dinhanh7/Logic_Analyzer_20261/dinhanh/PCB/LogicAnalyzer_Pico2/review/PCB_3D_isometric.png

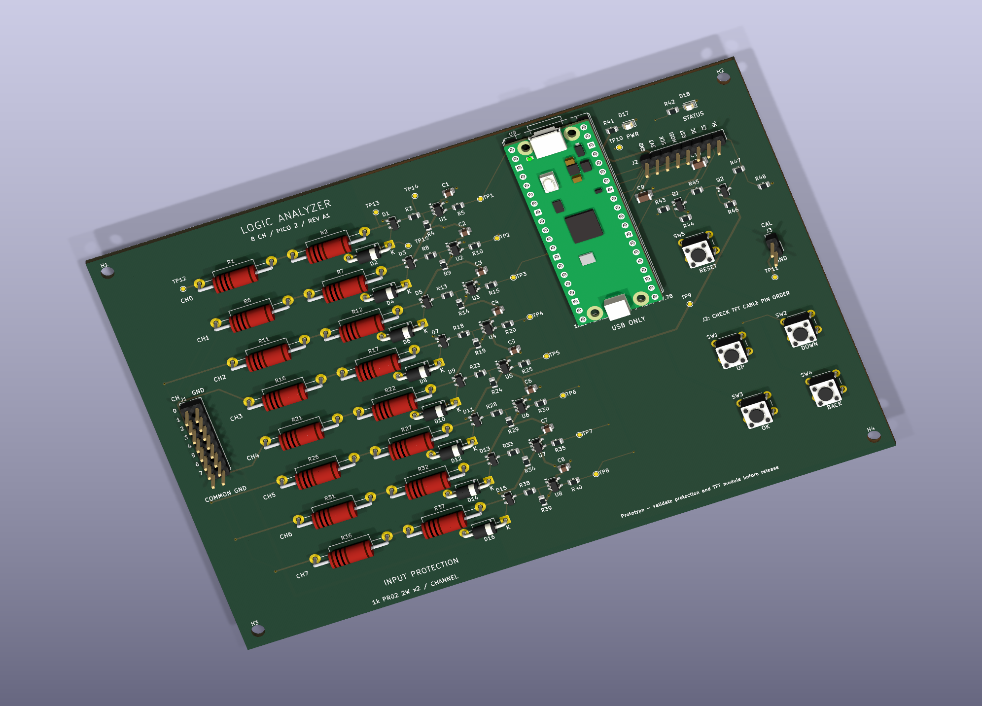
dinhanh/PCB/LogicAnalyzer_Pico2/review/PCB_3D_isometric.png
