dinhanh7/Logic_Analyzer_20261/dinhanh/PCB/LogicAnalyzer_Pico2/review/PCB_bottom.png

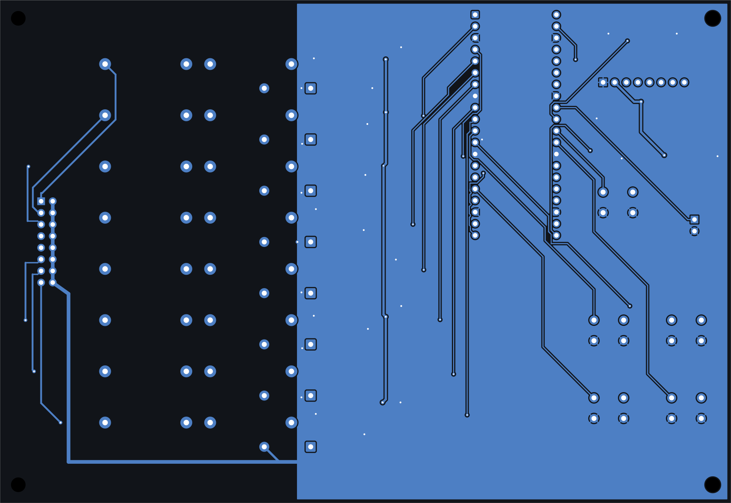
dinhanh/PCB/LogicAnalyzer_Pico2/review/PCB_bottom.png
