dinhanh7/Logic_Analyzer_20261/dinhanh/PCB/LogicAnalyzer_Pico2/models/RaspberryPi_Pico_H.step

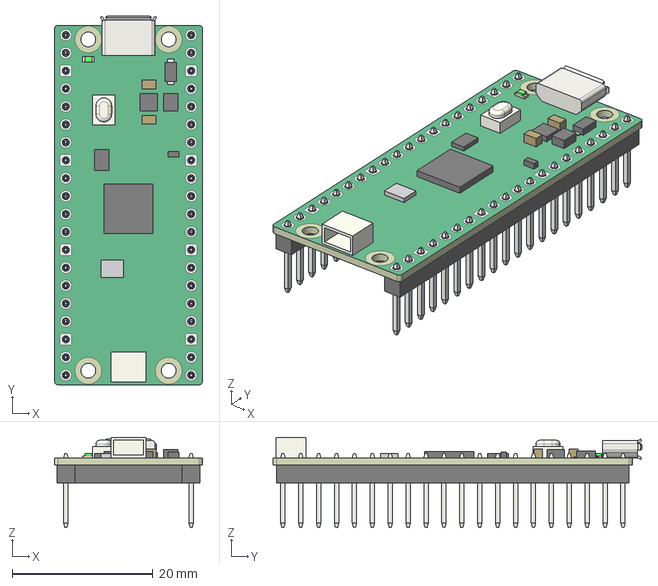
[picture p84: CAD file, 2026-11-11]
dinhanh/PCB/LogicAnalyzer_Pico2/models/RaspberryPi_Pico_H.step
21.0 x 52.3 x 12.8 mm
