dinhanh7/Logic_Analyzer_20261/dinhanh/PCB/LogicAnalyzer_Pico2/models/RaspberryPi_Pico_W_AddedHeaders_H2.54mm.step

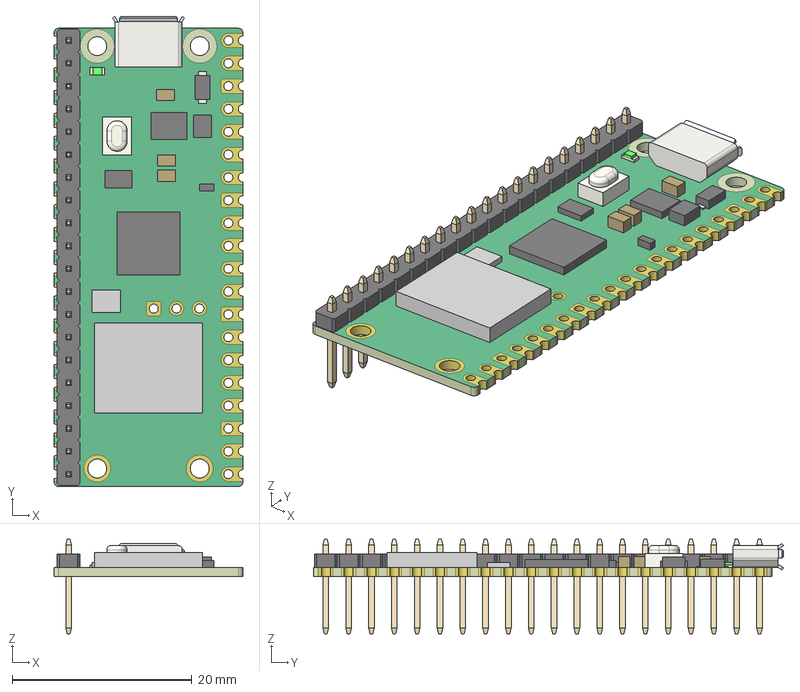
[picture p85: CAD file, 2026-11-11]
dinhanh/PCB/LogicAnalyzer_Pico2/models/RaspberryPi_Pico_W_AddedHeaders_H2.54mm.step
21.0 x 52.3 x 10.5 mm
