dinhanh7/Logic_Analyzer_20261/dinhanh/PCB/LogicAnalyzer_Pico2/models/SW_PUSH_6mm.step

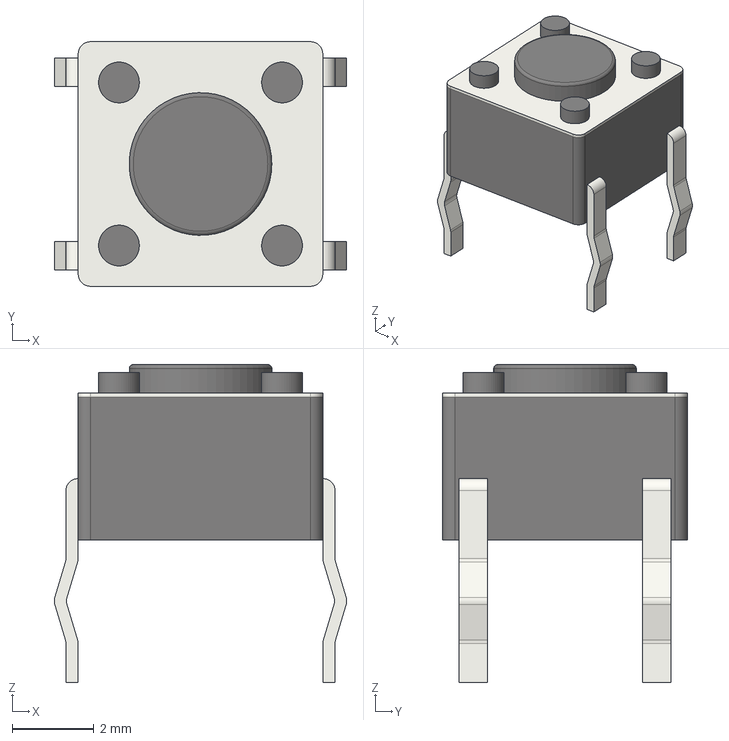
[picture p87: CAD file, 2026-11-11]
dinhanh/PCB/LogicAnalyzer_Pico2/models/SW_PUSH_6mm.step
7.17 x 6.00 x 7.80 mm
