dinhanh7/Logic_Analyzer_20261/dinhanh/PCB/LogicAnalyzer_Pico2/models/RaspberryPi_Pico_PinSockets_H8.50mm.step

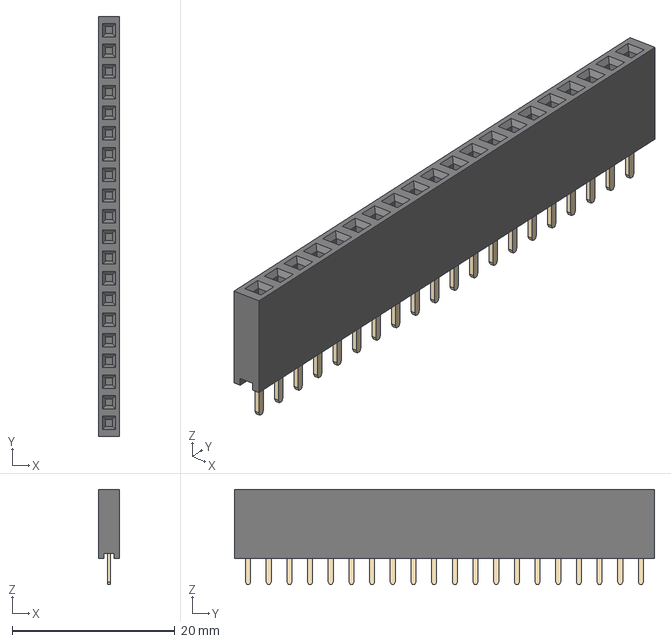
[picture p88: CAD file, 2026-11-11]
dinhanh/PCB/LogicAnalyzer_Pico2/models/RaspberryPi_Pico_PinSockets_H8.50mm.step
2.54 x 51.6 x 11.7 mm
