dinhanh7/Logic_Analyzer_20261/dinhanh/PCB/LogicAnalyzer_Pico2/models/LED_0805_2012Metric.step

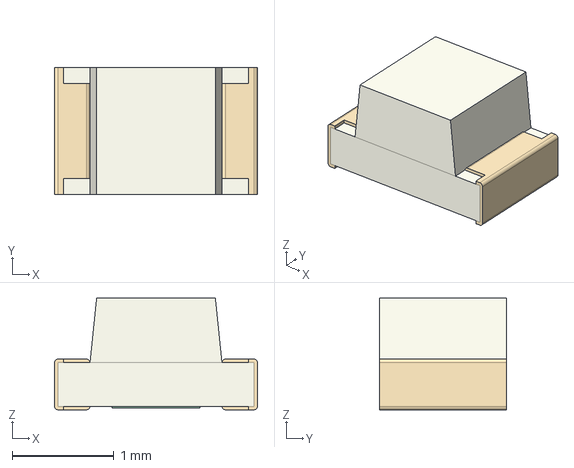
[picture p89: CAD file, 2026-11-11]
dinhanh/PCB/LogicAnalyzer_Pico2/models/LED_0805_2012Metric.step
2.00 x 1.25 x 1.10 mm
