dinhanh7/Logic_Analyzer_20261/dinhanh/PCB/LogicAnalyzer_Pico2/models/C_0805_2012Metric.step

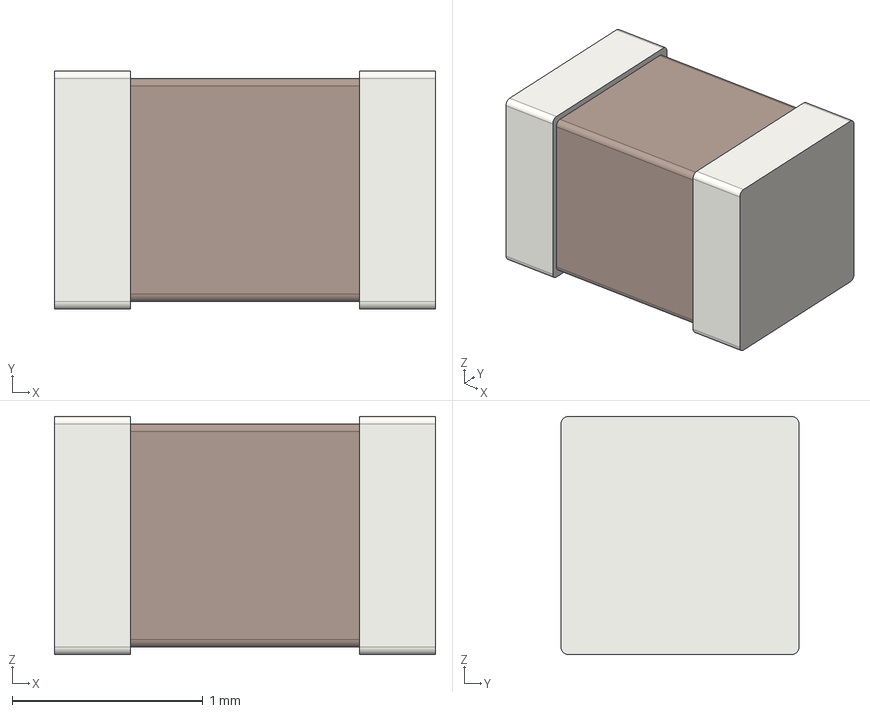
[picture p90: CAD file, 2026-11-11]
dinhanh/PCB/LogicAnalyzer_Pico2/models/C_0805_2012Metric.step
2.00 x 1.25 x 1.25 mm
