dinhanh7/Logic_Analyzer_20261/dinhanh/PCB/LogicAnalyzer_Pico2/models/D_DO-41_SOD81_P10.16mm_Horizontal.step

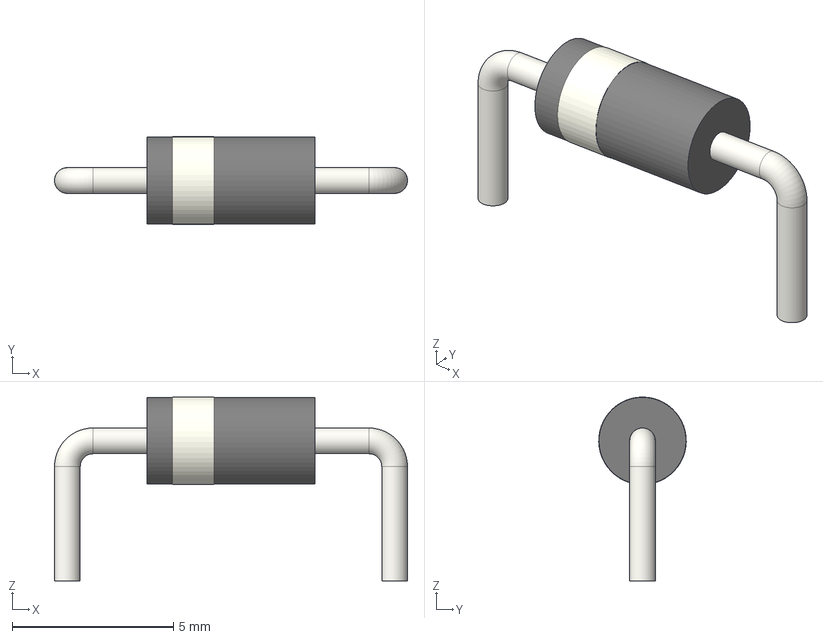
[picture p91: CAD file, 2026-11-11]
dinhanh/PCB/LogicAnalyzer_Pico2/models/D_DO-41_SOD81_P10.16mm_Horizontal.step
11.0 x 2.72 x 5.71 mm
