dinhanh7/Logic_Analyzer_20261/dinhanh/PCB/LogicAnalyzer_Pico2/models/PinHeader_2x08_P2.54mm_Vertical.step

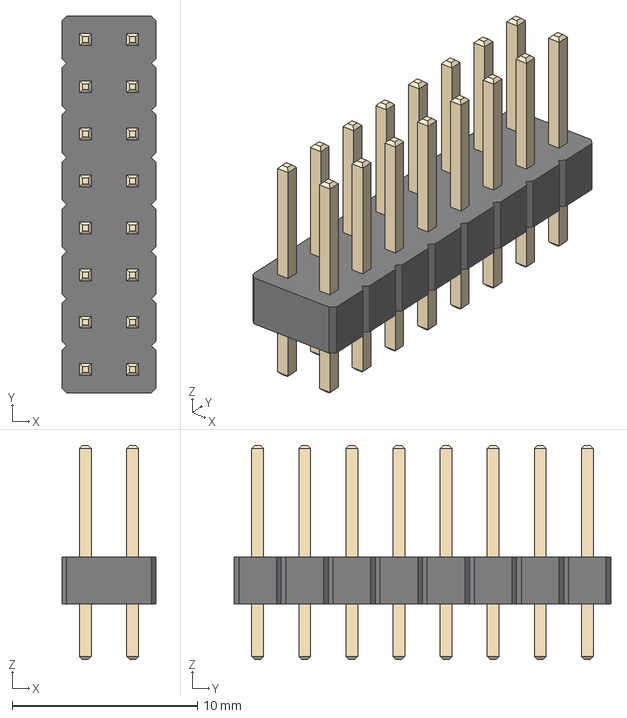
[picture p92: CAD file, 2026-11-11]
dinhanh/PCB/LogicAnalyzer_Pico2/models/PinHeader_2x08_P2.54mm_Vertical.step
5.08 x 20.3 x 11.5 mm
