dinhanh7/Logic_Analyzer_20261/dinhanh/PCB/LogicAnalyzer_Pico2/models/PinHeader_1x02_P2.54mm_Vertical.step

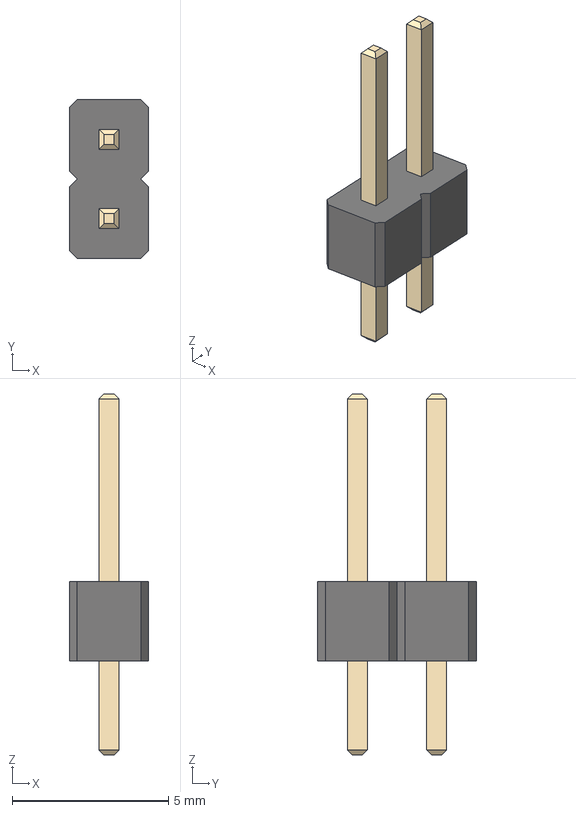
[picture p93: CAD file, 2026-11-11]
dinhanh/PCB/LogicAnalyzer_Pico2/models/PinHeader_1x02_P2.54mm_Vertical.step
2.54 x 5.08 x 11.5 mm
