dinhanh7/Logic_Analyzer_20261/dinhanh/PCB/LogicAnalyzer_Pico2/models/SOT-23.step

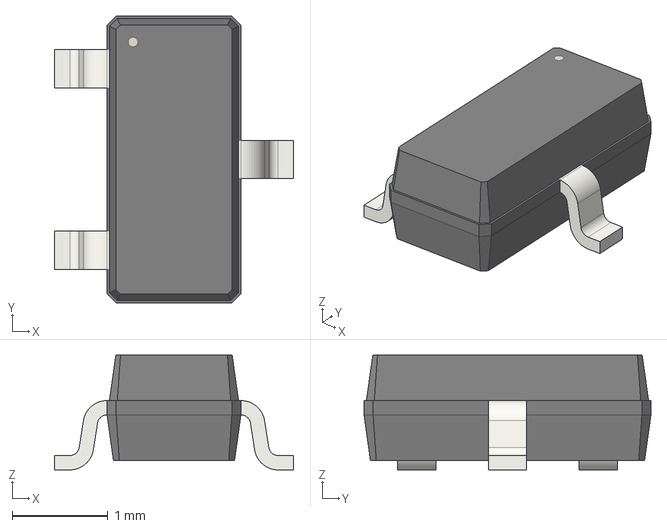
[picture p94: CAD file, 2026-11-11]
dinhanh/PCB/LogicAnalyzer_Pico2/models/SOT-23.step
2.50 x 3.00 x 1.20 mm
