dinhanh7/Logic_Analyzer_20261/dinhanh/PCB/LogicAnalyzer_Pico2/models/SOT-23-5.step

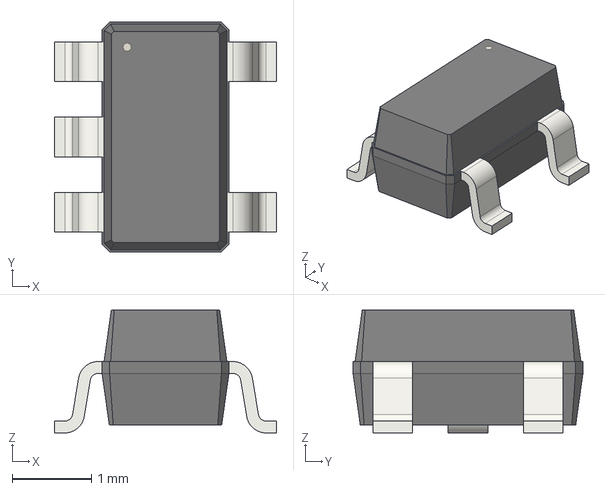
[picture p95: CAD file, 2026-11-11]
dinhanh/PCB/LogicAnalyzer_Pico2/models/SOT-23-5.step
2.80 x 2.90 x 1.55 mm
