dinhanh7/Logic_Analyzer_20261/dinhanh/PCB/LogicAnalyzer_Pico2/models/C_1206_3216Metric.step

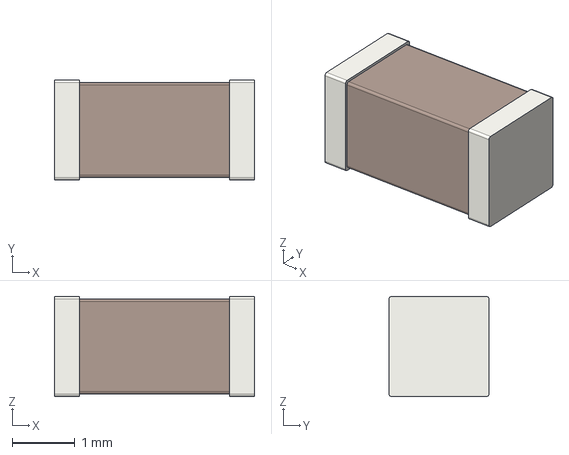
[picture p97: CAD file, 2026-11-11]
dinhanh/PCB/LogicAnalyzer_Pico2/models/C_1206_3216Metric.step
3.20 x 1.60 x 1.60 mm
