dinhanh7/Logic_Analyzer_20261/(list of files, cad)

Other CAD files:
dinhanh/PCB/LogicAnalyzer_Pico2/models/RaspberryPi_Pico_AddedHeaders_H2.54mm.step
