dinhanh7/Logic_Analyzer_20261/dinhanh/PCB/LogicAnalyzer_Pico2/review/Assembly.png

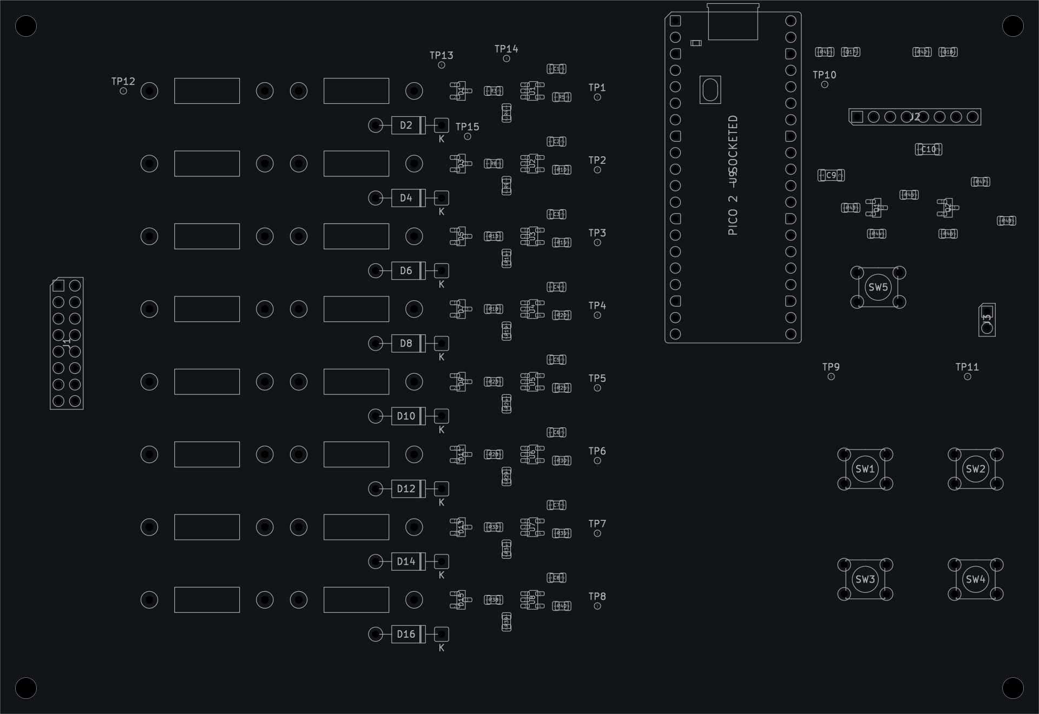
dinhanh/PCB/LogicAnalyzer_Pico2/review/Assembly.png
