dinhanh7/Logic_Analyzer_20261/dinhanh/mach_bao_ve/ltspice/verification_ngspice.txt

HISTORICAL RESULTS: separate CASE tests before the PWL sequence update.
Not verification of the current 12V/20ms -> 200V/1ms -> 5V/20ms source.

Cross-check of netlist extracted from ASC geometry.
Simulator: ngspice 36, Gear maxord=1, 27 deg C. Native LTspice unavailable on host.
Representative models only; not proof of hardware protection.

CASE=0 (12 V DC)
a_max               =  3.813493e+00 at=  1.196400e-05
clamp_max           =  3.840269e+00 at=  1.196400e-05
out_max             =  3.300000e+00 at=  4.000000e-10
iin_min             =  -4.079866e-03 at=  1.152400e-05

CASE=1 (3.3 V / 1 MHz square)
a_max               =  3.129543e+00 at=  1.050000e-05
clamp_max           =  3.151531e+00 at=  1.050000e-05
out_max             =  3.300000e+00 at=  4.505446e-06
iin_min             =  -1.408596e-03 at=  1.005000e-06

CASE=2 (200 V / 1 ms pulse)
a_max               =  4.319333e+00 at=  1.009133e-03
clamp_max           =  4.349660e+00 at=  1.009133e-03
out_max             =  3.300000e+00 at=  1.010050e-03
iin_min             =  -9.800488e-02 at=  1.002000e-05
