dinhanh7/Logic_Analyzer_20261/dinhanh/PCB/LogicAnalyzer_Pico2/review/Schematic.pdf

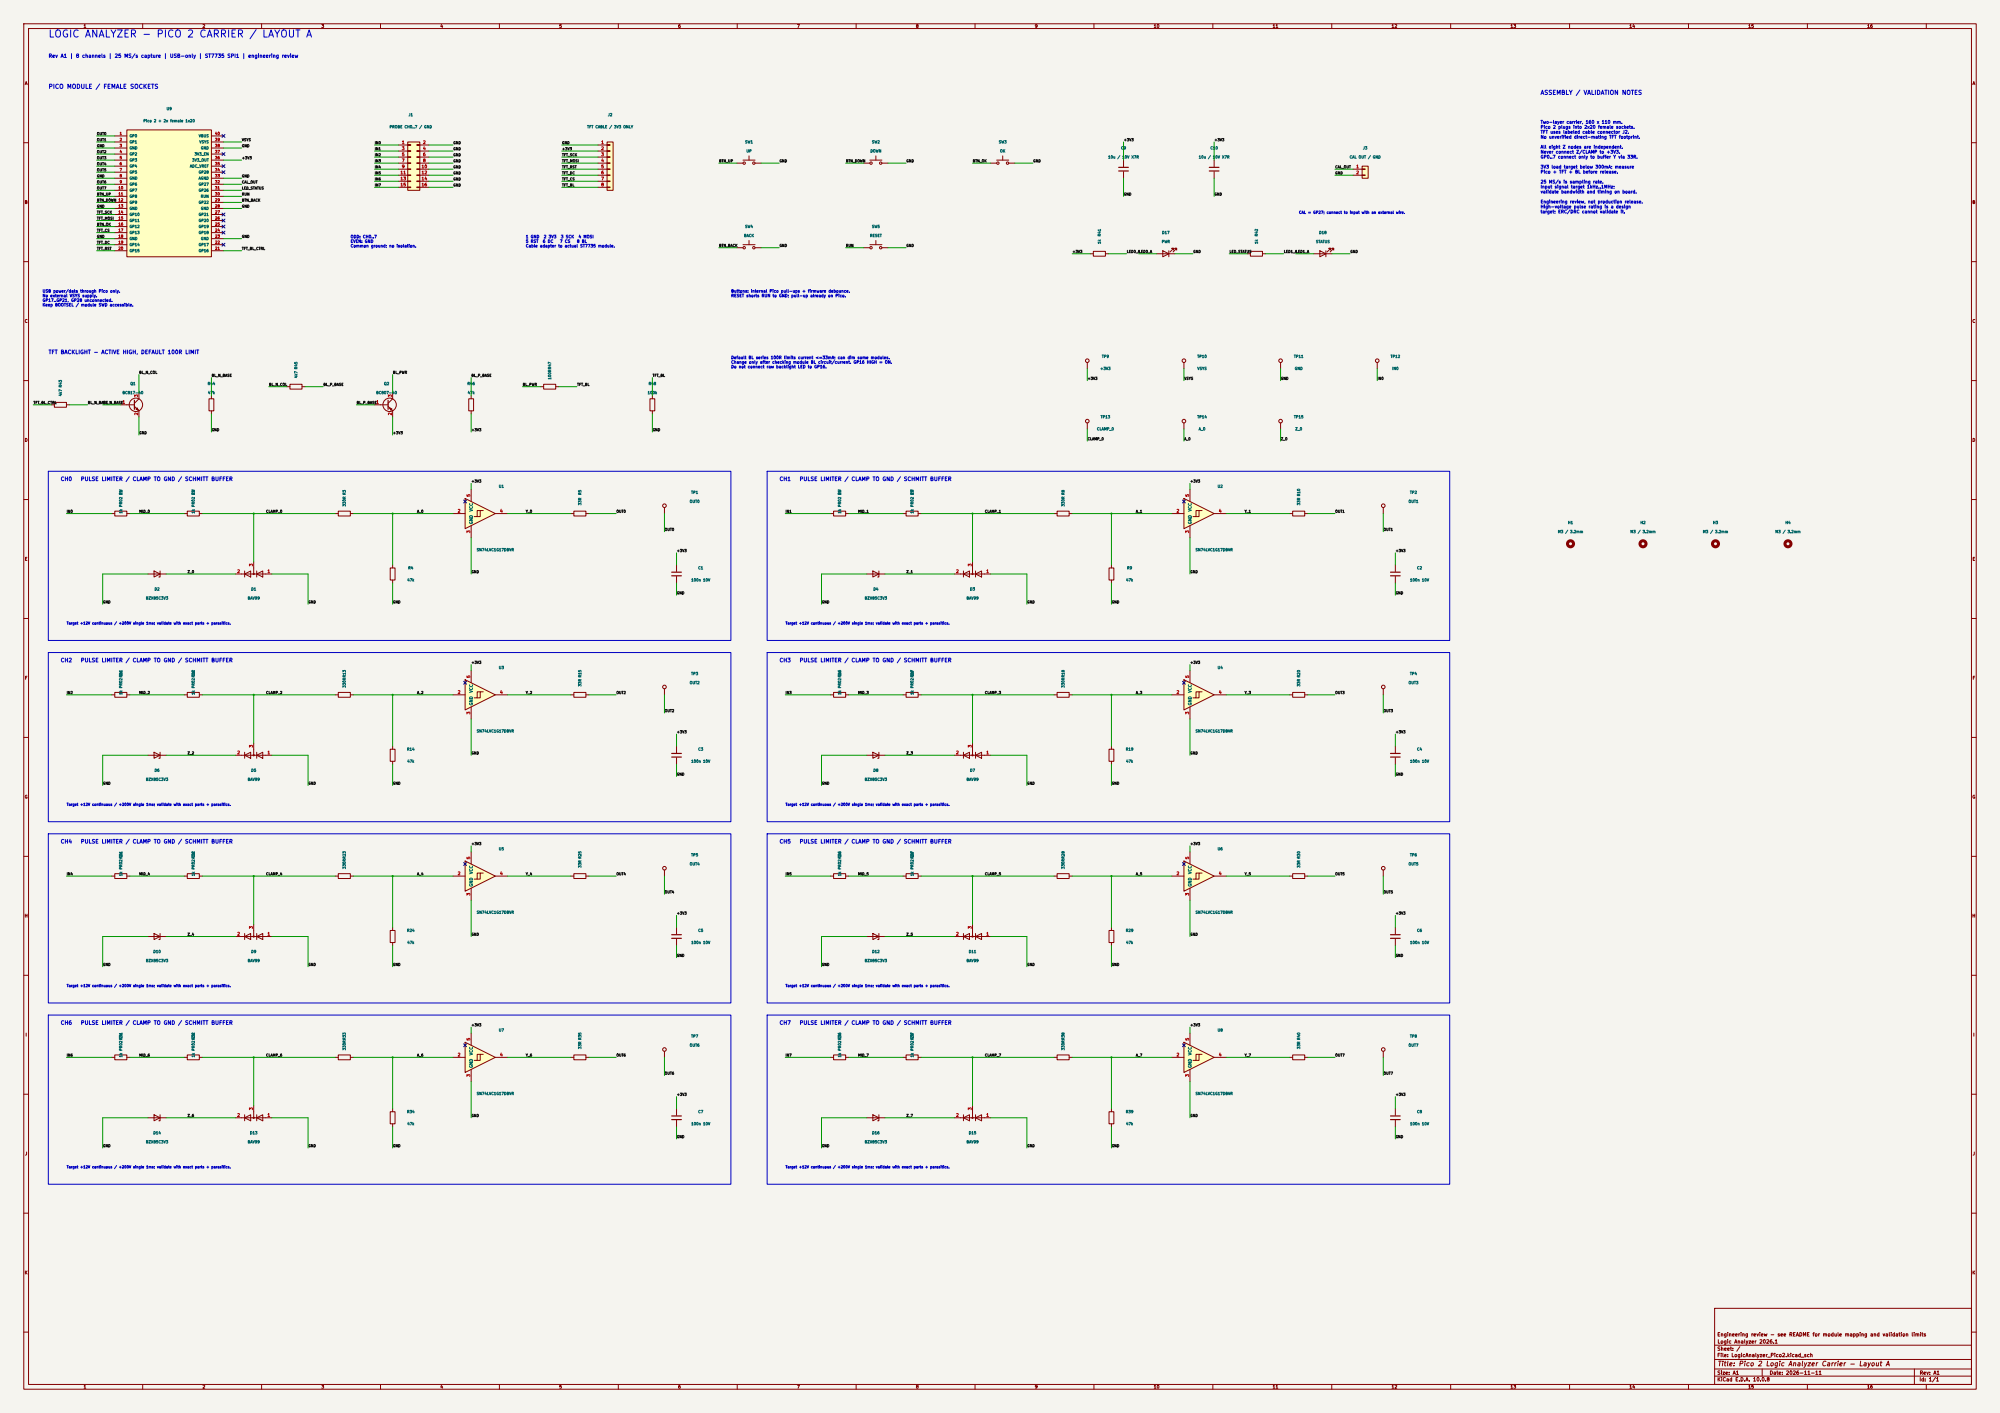
[picture p99: page 1]

LOGIC ANALYZER - PICO 2 CARRIER / LAYOUT A

Rev A1 | 8 channels | 25 MS/s capture | USB-only | ST7735 SPI1 | engineering review

PICO MODULE / FEMALE SOCKETS

Input signal target 1kHz..1MHz; validate bandwidth and timing on board. Engineering review, not production release. High-voltage pulse rating is a design

CAL = GP27; connect to input with an external wire.

target; ERC/DRC cannot validate it.

USB power/data through Pico only. No external VSYS supply. GP17..GP21, GP28 unconnected. Keep BOOTSEL / module SWD accessible.

Buttons: internal Pico pull-ups + firmware debounce. RESET shorts RUN to GND; pull-up already on Pico.

Default BL series 100R limits current <=33mA; can dim some modules. Change only after checking module BL circuit/current. GP16 HIGH = ON. Do not connect raw backlight LED to GP16.

Target +12V continuous / +200V single 1ms; validate with exact parts + parasitics.

Engineering review - see README for module mapping and validation limits
Logic Analyzer 2026.1
Sheet: /
File: LogicAnalyzer_Pico2.kicad_sch
Title: Pico 2 Logic Analyzer Carrier - Layout A

Size: A1 | Rev: A1
KiCad E.D.A. 10.0.8 | Id: 1/1
