dinhanh7/Logic_Analyzer_20261/dinhanh/PCB/LogicAnalyzer_Pico2/review/PCB_top_1to1.pdf

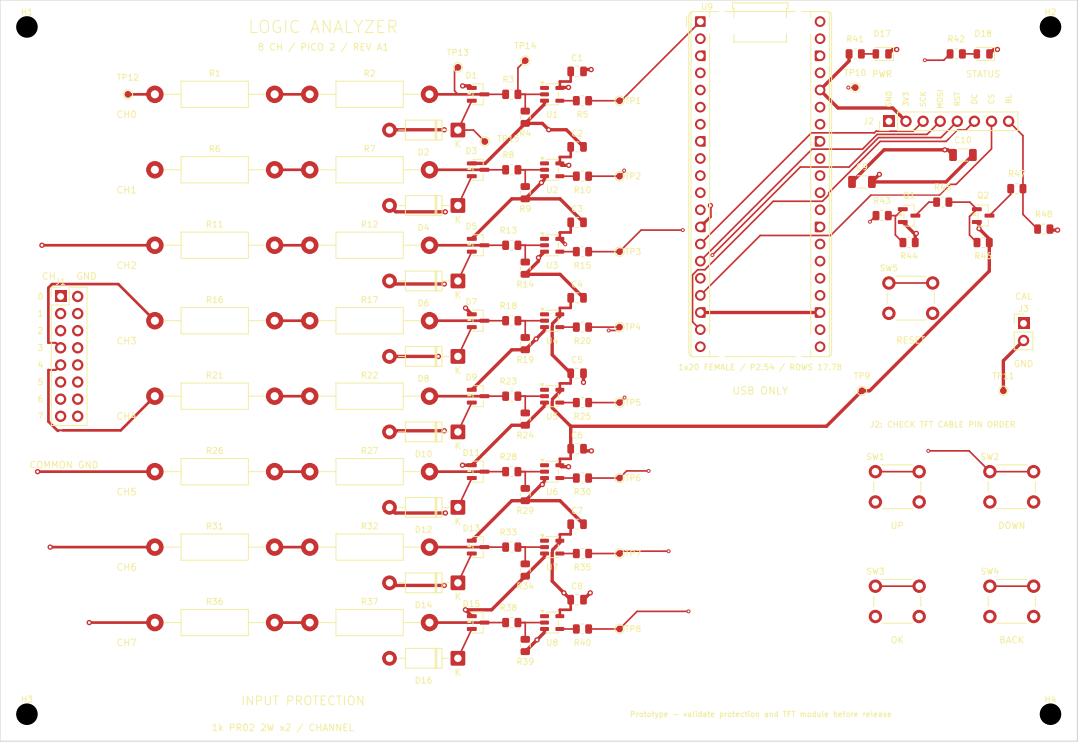
[picture p100: page 1]

J2: CHECK TFT CABLE PIN ORDER 0
CAL GND COMMON GND
