dinhanh7/Logic_Analyzer_20261/dinhanh/PCB/LogicAnalyzer_Pico2/review/PCB_bottom_1to1.pdf

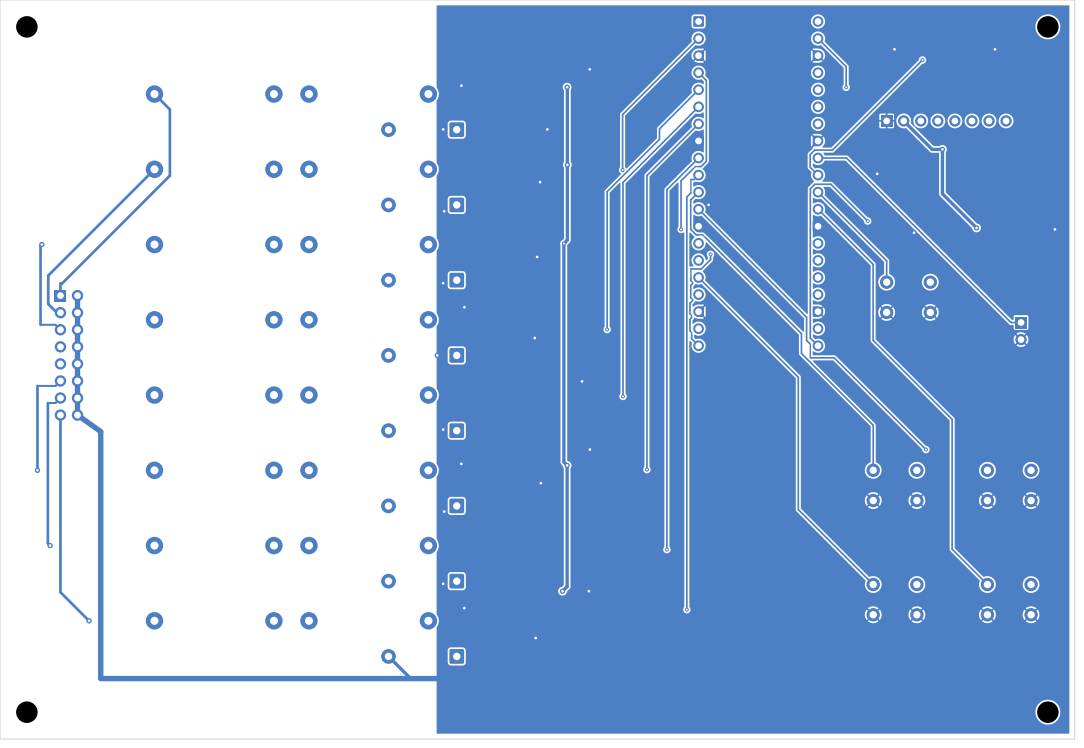
[picture p101: page 1]
