dinhanh7/Logic_Analyzer_20261/dinhanh/mach_bao_ve/ltspice/input_protection_1ch.asc

C2: la_cap_v; 100n
CLOAD: la_cap_v; 10p
D4: la_zener; D_BZX85C3V3_REP
R6: la_res_h; 2k
R8: la_res_h; 330
R9: la_res_v; 47k
R10: la_res_h; 33
VCCSRC: la_source; {VSUP}
VIN: la_source; PWL FILE="input_sequence.pwl"
XD3: la_bav99; BAV99_PAIR
XU2: la_schmitt; LVC1G17_REP
Named nets: IN, CLAMP, A, OUT, Z, 0, VCC
.include simulation_commands.inc
.tran {TMAX} {TSTOP} 0 {TMAX}
