dinhanh7/Logic_Analyzer_20261/(list of files, drawings)

Other design files:
dinhanh/PCB/LogicAnalyzer_Pico2/review/unrouted.dsn
