dinhanh7/Logic_Analyzer_20261/dinhanh/PCB/LogicAnalyzer_Pico2/LogicAnalyzer_Pico2.kicad_pcb

## KiCad design dinhanh/PCB/LogicAnalyzer_Pico2/LogicAnalyzer_Pico2.kicad_pcb (2026-11-11)

Schematic: LogicAnalyzer_Pico2.kicad_sch, Pico 2 Logic Analyzer Carrier - Layout A

Parts:
C1, C2, C3, C4, C5, C6, C7, C8: 100n 10V; C0805
C9, C10: 10u / 10V X7R; C1206
D1, D3, D5, D7, D9, D11, D13, D15: BAV99; SOT23
D2, D4, D6, D8, D10, D12, D14, D16: BZX85C3V3; Zener_DO41
D17: PWR; LED0805
D18: STATUS; LED0805
H1, H2, H3, H4: M3 / 3.2mm; Hole_M3
J1: PROBE CH0..7 / GND; Probe_2x08
J2: TFT CABLE / 3V3 ONLY; TFT_1x08
J3: CAL OUT / GND; CAL_1x02
Q1: BC817-40; SOT23
Q2: BC807-40; SOT23
R1, R2, R6, R7, R11, R12, R16, R17, R21, R22, R26, R27, R31, R32, R36, R37: 1k PR02 2W; PR02_1k_2W_P17.78
R3, R8, R13, R18, R23, R28, R33, R38: 330R; R0805
R4, R9, R14, R19, R24, R29, R34, R39, R44, R46: 47k; R0805
R5, R10, R15, R20, R25, R30, R35, R40: 33R; R0805
R41, R42: 1k; R0805
R43, R45: 4k7; R0805
R47: 100R; R0805
R48: 100k; R0805
SW1: UP; SW_6mm
SW2: DOWN; SW_6mm
SW3: OK; SW_6mm
SW4: BACK; SW_6mm
SW5: RESET; SW_6mm
TP1: OUT0; TP_1mm
TP2: OUT1; TP_1mm
TP3: OUT2; TP_1mm
TP4: OUT3; TP_1mm
TP5: OUT4; TP_1mm
TP6: OUT5; TP_1mm
TP7: OUT6; TP_1mm
TP8: OUT7; TP_1mm
TP9: +3V3; TP_1mm
TP10: VSYS; TP_1mm
TP11: GND; TP_1mm
TP12: IN0; TP_1mm
TP13: CLAMP_0; TP_1mm
TP14: A_0; TP_1mm
TP15: Z_0; TP_1mm
U1, U2, U3, U4, U5, U6, U7, U8: SN74LVC1G17DBVR; SOT23_5
U9: Pico 2 + 2x female 1x20; Pico2_Sockets

Connections:
/+3V3: C1.1, C2.1, C3.1, C4.1, C5.1, C6.1, C7.1, C8.1, C9.1, C10.1, J2.2, Q2.2 (E), R41.1, R46.2, TP9.1, U1.5 (VCC), U2.5 (VCC), U3.5 (VCC), U4.5 (VCC), U5.5 (VCC), U6.5 (VCC), U7.5 (VCC), U8.5 (VCC), U9.36 (3V3_OUT)
/A_0: R3.2, R4.1, TP14.1, U1.2
/A_1: R8.2, R9.1, U2.2
/A_2: R13.2, R14.1, U3.2
/A_3: R18.2, R19.1, U4.2
/A_4: R23.2, R24.1, U5.2
/A_5: R28.2, R29.1, U6.2
/A_6: R33.2, R34.1, U7.2
/A_7: R38.2, R39.1, U8.2
/BL_N_BASE: Q1.1 (B), R43.2, R44.1
/BL_N_COL: Q1.3 (C), R45.1
/BL_PWR: Q2.3 (C), R47.1
/BL_P_BASE: Q2.1 (B), R45.2, R46.1
/BTN_BACK: SW4.1, U9.29 (GP22)
/BTN_DOWN: SW2.1, U9.12 (GP9)
/BTN_OK: SW3.1, U9.16 (GP12)
/BTN_UP: SW1.1, U9.11 (GP8)
/CAL_OUT: J3.1, U9.32 (GP27)
/CLAMP_0: D1.3 (K1_A2), R2.2, R3.1, TP13.1
/CLAMP_1: D3.3 (K1_A2), R7.2, R8.1
/CLAMP_2: D5.3 (K1_A2), R12.2, R13.1
/CLAMP_3: D7.3 (K1_A2), R17.2, R18.1
/CLAMP_4: D9.3 (K1_A2), R22.2, R23.1
/CLAMP_5: D11.3 (K1_A2), R27.2, R28.1
/CLAMP_6: D13.3 (K1_A2), R32.2, R33.1
/CLAMP_7: D15.3 (K1_A2), R37.2, R38.1
/GND: C1.2, C2.2, C3.2, C4.2, C5.2, C6.2, C7.2, C8.2, C9.2, C10.2, D1.1 (A1), D2.2 (A), D3.1 (A1), D4.2 (A), D5.1 (A1), D6.2 (A), D7.1 (A1), D8.2 (A), D9.1 (A1), D10.2 (A), D11.1 (A1), D12.2 (A), D13.1 (A1), D14.2 (A), D15.1 (A1), D16.2 (A), D17.1 (K), D18.1 (K), J1.2, J1.4, J1.6, J1.8, J1.10, J1.12, J1.14, J1.16, J2.1, J3.2, Q1.2 (E), R4.2, R9.2, R14.2, R19.2, R24.2, R29.2, R34.2, R39.2, R44.2, R48.2, SW1.2, SW2.2, SW3.2, SW4.2, SW5.2, TP11.1, U1.3 (GND), U2.3 (GND), U3.3 (GND), U4.3 (GND), U5.3 (GND), U6.3 (GND), U7.3 (GND), U8.3 (GND), U9.3 (GND), U9.8 (GND), U9.13 (GND), U9.18 (GND), U9.23 (GND), U9.28 (GND), U9.33 (AGND), U9.38 (GND)
/IN0: J1.1, R1.1, TP12.1
/IN1: J1.3, R6.1
/IN2: J1.5, R11.1
/IN3: J1.7, R16.1
/IN4: J1.9, R21.1
/IN5: J1.11, R26.1
/IN6: J1.13, R31.1
/IN7: J1.15, R36.1
/LED0_A: D17.2 (A), R41.2
/LED1_A: D18.2 (A), R42.2
/LED_STATUS: R42.1, U9.31 (GP26)
/MID_0: R1.2, R2.1
/MID_1: R6.2, R7.1
/MID_2: R11.2, R12.1
/MID_3: R16.2, R17.1
/MID_4: R21.2, R22.1
/MID_5: R26.2, R27.1
/MID_6: R31.2, R32.1
/MID_7: R36.2, R37.1
/OUT0: R5.2, TP1.1, U9.1 (GP0)
/OUT1: R10.2, TP2.1, U9.2 (GP1)
/OUT2: R15.2, TP3.1, U9.4 (GP2)
/OUT3: R20.2, TP4.1, U9.5 (GP3)
/OUT4: R25.2, TP5.1, U9.6 (GP4)
/OUT5: R30.2, TP6.1, U9.7 (GP5)
/OUT6: R35.2, TP7.1, U9.9 (GP6)
/OUT7: R40.2, TP8.1, U9.10 (GP7)
/RUN: SW5.1, U9.30 (RUN)
/TFT_BL: J2.8, R47.2, R48.1
/TFT_BL_CTRL: R43.1, U9.21 (GP16)
/TFT_CS: J2.7, U9.17 (GP13)
/TFT_DC: J2.6, U9.19 (GP14)
/TFT_MOSI: J2.4, U9.15 (GP11)
/TFT_RST: J2.5, U9.20 (GP15)
/TFT_SCK: J2.3, U9.14 (GP10)
/VSYS: TP10.1, U9.39 (VSYS)
/Y_0: R5.1, U1.4
/Y_1: R10.1, U2.4
/Y_2: R15.1, U3.4
/Y_3: R20.1, U4.4
/Y_4: R25.1, U5.4
/Y_5: R30.1, U6.4
/Y_6: R35.1, U7.4
/Y_7: R40.1, U8.4
/Z_0: D1.2 (K2), D2.1 (K), TP15.1
/Z_1: D3.2 (K2), D4.1 (K)
/Z_2: D5.2 (K2), D6.1 (K)
/Z_3: D7.2 (K2), D8.1 (K)
/Z_4: D9.2 (K2), D10.1 (K)
/Z_5: D11.2 (K2), D12.1 (K)
/Z_6: D13.2 (K2), D14.1 (K)
/Z_7: D15.2 (K2), D16.1 (K)

Notes on the sheet:
LOGIC ANALYZER - PICO 2 CARRIER / LAYOUT A
Rev A1 | 8 channels | 25 MS/s capture | USB-only | ST7735 SPI1 | engineering review
PICO MODULE / FEMALE SOCKETS
USB power/data through Pico only. No external VSYS supply. GP17..GP21, GP28 unconnected. Keep BOOTSEL / module SWD accessible.
ODD: CH0..7 EVEN: GND Common ground; no isolation.
1 GND 2 3V3 3 SCK 4 MOSI 5 RST 6 DC 7 CS 8 BL Cable adapter to actual ST7735 module.
Buttons: internal Pico pull-ups + firmware debounce. RESET shorts RUN to GND; pull-up already on Pico.
CAL = GP27; connect to input with an external wire.
TFT BACKLIGHT - ACTIVE HIGH, DEFAULT 100R LIMIT
Default BL series 100R limits current <=33mA; can dim some modules. Change only after checking module BL circuit/current. GP16 HIGH = ON. Do not connect raw backlight LED to GP16.
CH0 PULSE LIMITER / CLAMP TO GND / SCHMITT BUFFER
Target +12V continuous / +200V single 1ms; validate with exact parts + parasitics.
CH1 PULSE LIMITER / CLAMP TO GND / SCHMITT BUFFER
CH2 PULSE LIMITER / CLAMP TO GND / SCHMITT BUFFER
CH3 PULSE LIMITER / CLAMP TO GND / SCHMITT BUFFER
CH4 PULSE LIMITER / CLAMP TO GND / SCHMITT BUFFER
CH5 PULSE LIMITER / CLAMP TO GND / SCHMITT BUFFER
CH6 PULSE LIMITER / CLAMP TO GND / SCHMITT BUFFER
CH7 PULSE LIMITER / CLAMP TO GND / SCHMITT BUFFER
ASSEMBLY / VALIDATION NOTES
Two-layer carrier, 160 x 110 mm. Pico 2 plugs into 2x20 female sockets. TFT uses labeled cable connector J2. No unverified direct-mating TFT footprint. All eight Z nodes are independent. Never connect Z/CLAMP to +3V3. GP0..7 connect only to buffer Y via 33R. 3V3 load target below 300mA; measure Pic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

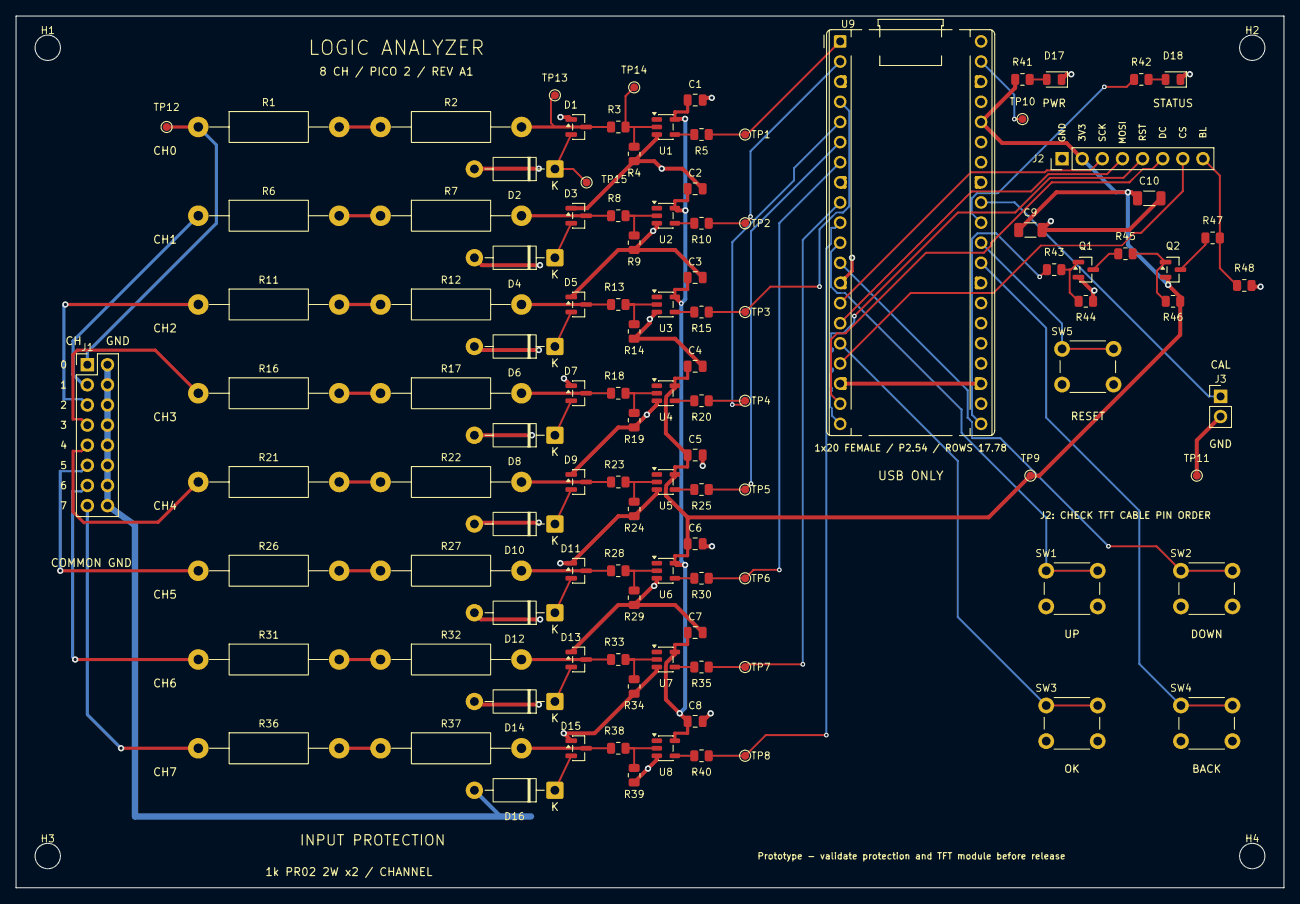
[picture p102: board LogicAnalyzer_Pico2.kicad_pcb from above]

Board: 2 copper layers, 160.0 x 110.0 mm, 114 parts (0 on the bottom side), 79 nets.
