dinhanh7/Logic_Analyzer_20261/(commit log)

2026-10-20 up firmware, da ket noi duoc voi pico 2
2026-11-05 up bao ve mach kicad va ltspice
    [BOM.csv, input_protection.kicad_sch, results.csv]
2026-11-11 up mach PCB
    [BOM.csv, BOM_grouped.csv, C_0805_2012Metric.step, C_1206_3216Metric.step, D_DO-41_SOD81_P10.16mm_Horizontal.step, LED_0805_2012Metric.step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]
2026-11-11 docs: add RAM FIFO and DMA capture architecture review
