dinhanh7/Logic_Analyzer_20261/(notices)

Notices in the files:
dinhanh/PCB/LogicAnalyzer_Pico2/models/C_0805_2012Metric.step:
Copyright (C) 2017, kicad StepUp
This work is licensed under the [Creative Commons CC-BY-SA 4.0 License](https://creativecommons.org/licenses/by-sa/4.0/legalcode),
with the following exception:
To the extent that the creation of electronic designs that use 'Licensed Material' can be considered to be 'Adapted Material',
You are free to use the library data in your own projects without the obligation to share your project files under this or any other license agreement.
dinhanh/PCB/LogicAnalyzer_Pico2/models/R_0805_2012Metric.step:
Copyright (C) 2018, kicad StepUp
dinhanh/PCB/LogicAnalyzer_Pico2/models/SOT-23-5.step:
Copyright (C) 2025, KiCAD
This work is licensed under the
[Creative Commons CC-BY-SA 4.0 License](https://creativecommons.org/licenses/by-sa/4.0/legalcode),
project files under this or any other license agreement. However, if you wish to distribute
